eenest/AA-W6EEN/doc/AA-W6EEN-1.jpg

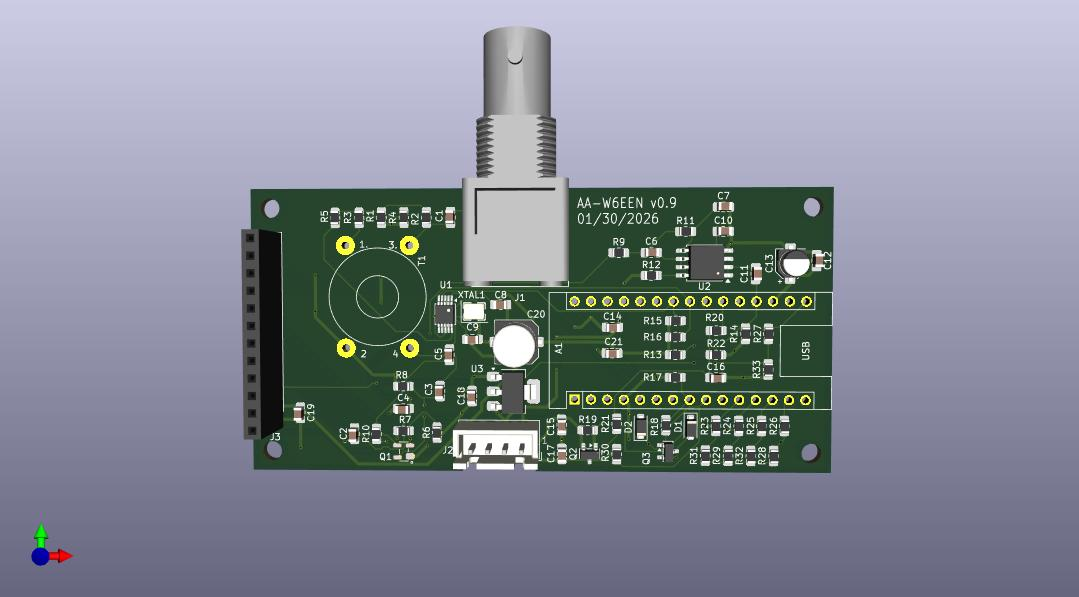
doc/AA-W6EEN-1.jpg
