eenest/AA-W6EEN/doc/AA-W6EEN-3.jpg

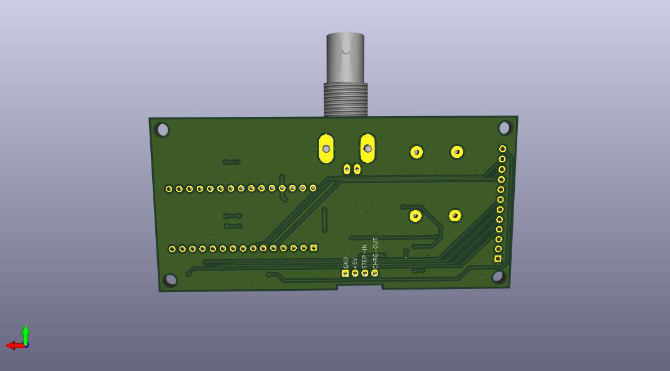
doc/AA-W6EEN-3.jpg
