eenest/AA-W6EEN/doc/AA-W6EEN-2.jpg

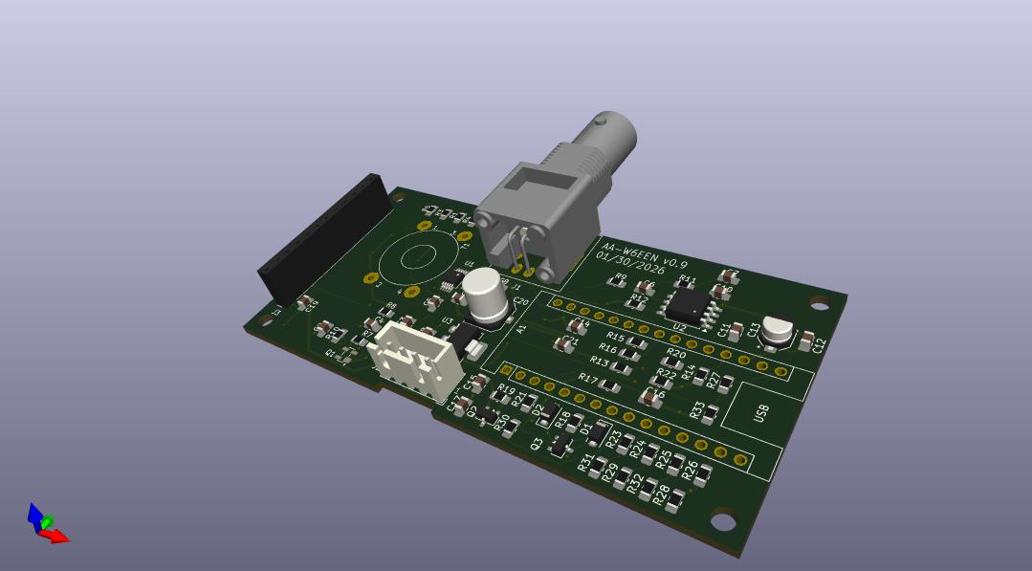
doc/AA-W6EEN-2.jpg
