eenest/AA-W6EEN/doc/AA-W6EEN-schemacis.pdf

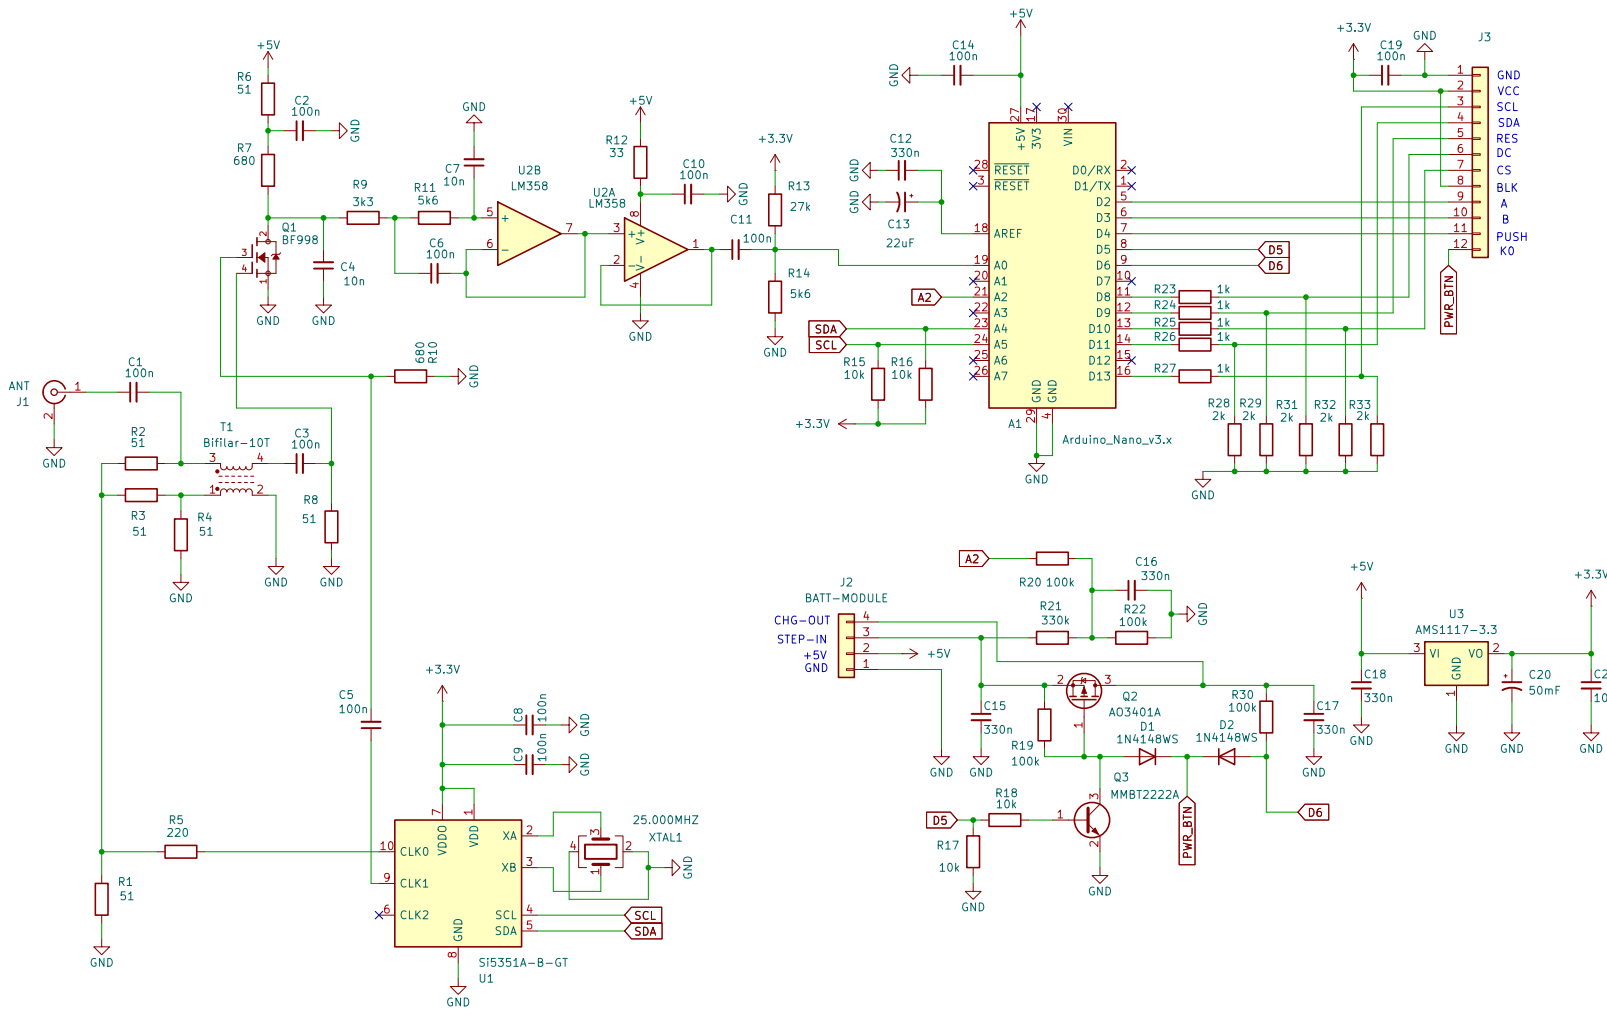
[picture p4: page 1]
