eenest/AA-W6EEN/KiCad/AA-W6EEN.kicad_pcb

## KiCad design KiCad/AA-W6EEN.kicad_pcb (2026-04-02)

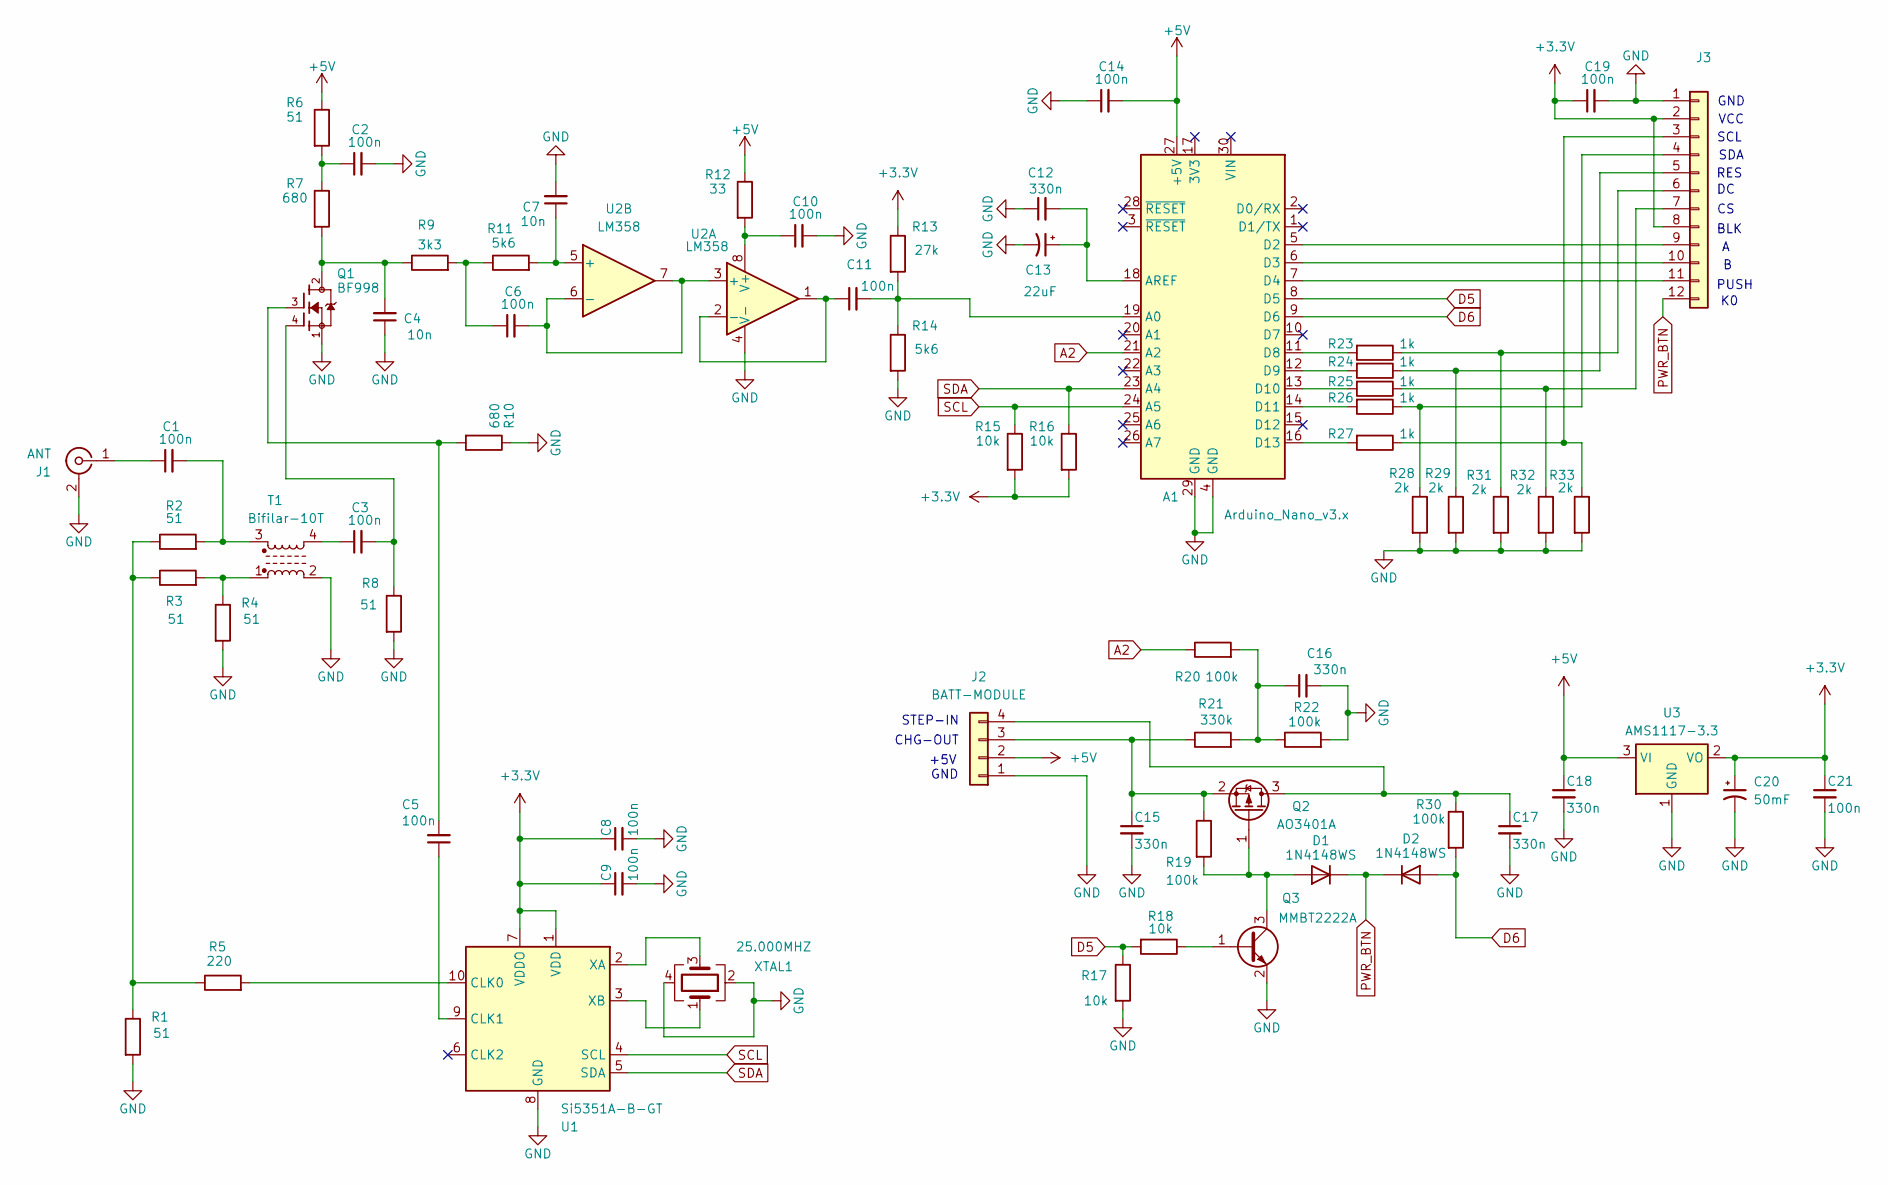
[picture p5: schematic AA-W6EEN.kicad_sch]

Parts:
A1: Arduino_Nano_v3.x; Arduino_Nano
C1, C2, C3, C5, C6, C8, C9, C10, C11, C14, C19, C21: 100n; C_0805_2012Metric_Pad1.18x1.45mm_HandSolder
C4, C7: 10n; C_0805_2012Metric_Pad1.18x1.45mm_HandSolder
C12, C15, C16, C17, C18: 330n; C_0805_2012Metric_Pad1.18x1.45mm_HandSolder
C13: 22uF; CP_Elec_4x3
C20: 50mF; C_Elec_6.3x7.7
D1, D2: 1N4148WS; D_SOD-123F
J1: ANT; BNC_Amphenol_B6252HB-NPP3G-50_Horizontal
J2: BATT-MODULE; JST_XH_B4B-XH-A_1x04_P2.50mm_Vertical
J3: 2.4" TFT with EC11; PinSocket_1x12_P2.54mm_Vertical
Q1: BF998; SOT190P230X110-4N
Q2: AO3401A; SOT-23
Q3: MMBT2222A; SOT-23
R1, R2, R3, R4, R6, R8: 51; R_0805_2012Metric_Pad1.20x1.40mm_HandSolder
R5: 220; R_0805_2012Metric_Pad1.20x1.40mm_HandSolder
R7, R10: 680; R_0805_2012Metric_Pad1.20x1.40mm_HandSolder
R9: 3k3; R_0805_2012Metric_Pad1.20x1.40mm_HandSolder
R11, R14: 5k6; R_0805_2012Metric_Pad1.20x1.40mm_HandSolder
R12: 33; R_0805_2012Metric_Pad1.20x1.40mm_HandSolder
R13: 27k; R_0805_2012Metric_Pad1.20x1.40mm_HandSolder
R15, R16, R17, R18: 10k; R_0805_2012Metric_Pad1.20x1.40mm_HandSolder
R19, R20, R22, R30: 100k; R_0805_2012Metric_Pad1.20x1.40mm_HandSolder
R21: 330k; R_0805_2012Metric_Pad1.20x1.40mm_HandSolder
R23, R24, R25, R26, R27: 1k; R_0805_2012Metric_Pad1.20x1.40mm_HandSolder
R28, R29, R31, R32, R33: 2k; R_0805_2012Metric_Pad1.20x1.40mm_HandSolder
T1: Bifilar-10T; Transformer_Toroid_Horizontal_D14.0mm_Amidon-T50
U1: Si5351A-B-GT; MSOP-10_3x3mm_P0.5mm
U2: LM358; My-SOIC8
U3: AMS1117-3.3; SOT-223-3_TabPin2
XTAL1: 25.000MHZ; Crystal_SMD_3225-4Pin_3.2x2.5mm

Connections:
+3.3V: C8.1, C9.1, C19.1, C20.1, C21.1, J3.2, J3.8, R13.1, R15.2, R16.2, U1.1 (VDD), U1.7 (VDDO), U3.2 (VO)
+5V: A1.27 (+5V), C14.2, C18.1, J2.2, R6.1, R12.1, U3.3 (VI)
A2: A1.21 (A2), R20.1
D5: A1.8 (D5), R17.1, R18.2
D6: A1.9 (D6), D2.2 (A), R30.2
GND: A1.4 (GND), A1.29 (GND), C2.2, C4.1, C7.2, C8.2, C9.2, C10.2, C12.1, C13.2, C14.1, C15.2, C16.2, C17.2, C18.2, C19.2, C20.2, C21.2, J1.2 (Ext), J2.1, J3.1, Q1.1, Q3.2 (E), R1.2, R4.2, R8.2, R10.1, R14.2, R17.2, R22.2, R28.2, R29.2, R31.2, R32.2, R33.2, T1.2, U1.8 (GND), U2.4 (V-), U3.1 (GND), XTAL1.2, XTAL1.4
unnamed: A1.19 (A0), C11.2, R13.2, R14.1
unnamed: A1.18 (AREF), C12.2, C13.1
unnamed: A1.5 (D2), J3.9
unnamed: A1.6 (D3), J3.10
unnamed: A1.7 (D4), J3.11
unnamed: A1.11 (D8), R23.2
unnamed: A1.12 (D9), R24.2
unnamed: A1.13 (D10), R25.2
unnamed: A1.14 (D11), R26.2
unnamed: A1.16 (D13), R27.2
unnamed: C1.2, R2.2, T1.3
unnamed: C2.1, R6.2, R7.1
unnamed: C3.1, T1.4
unnamed: C3.2, Q1.4, R8.1
unnamed: C4.2, Q1.2, R7.2, R9.1
unnamed: C5.2, Q1.3, R10.2
unnamed: C6.1, R9.2, R11.1
unnamed: C16.1, R20.2, R21.2, R22.1
unnamed: D1.2 (A), Q2.1 (G), Q3.3 (C), R19.2
unnamed: C1.1, J1.1 (In)
unnamed: C15.1, J2.3, Q2.2 (S), R19.1, R21.1
unnamed: C17.1, J2.4, Q2.3 (D), R30.1
unnamed: J3.3, R27.1, R33.1
unnamed: J3.4, R26.1, R28.1
unnamed: J3.5, R24.1, R29.1
unnamed: J3.6, R23.1, R31.1
unnamed: J3.7, R25.1, R32.1
unnamed: Q3.1 (B), R18.1
unnamed: R1.1, R2.1, R3.1, R5.1
unnamed: R3.2, R4.1, T1.1
unnamed: R5.2, U1.10 (CLK0)
unnamed: C5.1, U1.9 (CLK1)
unnamed: U1.2 (XA), XTAL1.3
unnamed: U1.3 (XB), XTAL1.1
unnamed: C6.2, U2.3 (+), U2.6 (-), U2.7
unnamed: C11.1, U2.1, U2.2 (-)
unnamed: C7.1, R11.2, U2.5 (+)
unnamed: C10.1, R12.2, U2.8 (V+)
PWR_BTN: D1.1 (K), D2.1 (K), J3.12
SCL: A1.24 (A5), R15.1, U1.4 (SCL)
SDA: A1.23 (A4), R16.1, U1.5 (SDA)

Notes on the sheet:
+5V
GND
STEP-IN
PUSH
SDA
CHG-OUT
BLK
VCC
RES
SCL

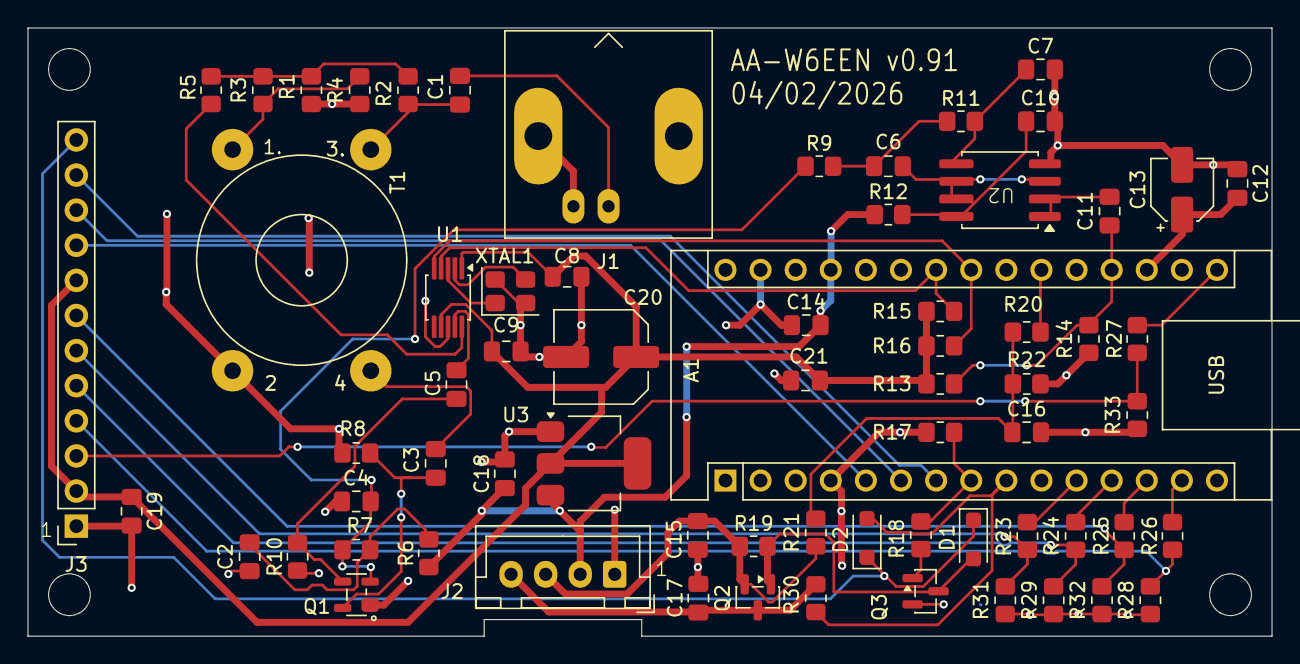
[picture p6: board AA-W6EEN.kicad_pcb from above]

Board: 2 copper layers, 90.0 x 44.0 mm, 68 parts (0 on the bottom side), 47 nets.
