eenest/AA-W6EEN/(commit log)

2026-04-01 Initial save to GitHub
    [AA-W6EEN.csv, AA-W6EEN.kicad_pcb, AA-W6EEN.kicad_sch]
2026-04-02 Updated OPAMP footprint. Changed date/revision.
    [AA-W6EEN.kicad_pcb, AA-W6EEN.kicad_sch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]
2026-04-02 Updated SOIC8 footprijt. Fixed pwr silkscreen labels. Changed revision/date
    [AA-W6EEN-B_Paste.gbr, AA-W6EEN-B_Silkscreen.gbr, AA-W6EEN-Edge_Cuts.gbr, AA-W6EEN-F_Cu.gbr, AA-W6EEN-F_Mask.gbr, AA-W6EEN-F_Paste.gbr, AA-W6EEN-F_Silkscreen.gbr, AA-W6EEN-NPTH.drl]
